Biddai/Wireless-Igor/(list of files, cad)

Other CAD files:
3dfiles/Project IGOR Wireless Bambu.3mf
3dfiles/Project IGOR Wireless.f3d
